fhnw-ise-qcrypt/qsit_psd_payload_module_kicad/assembly/QSIT_PayloadADCboard.png

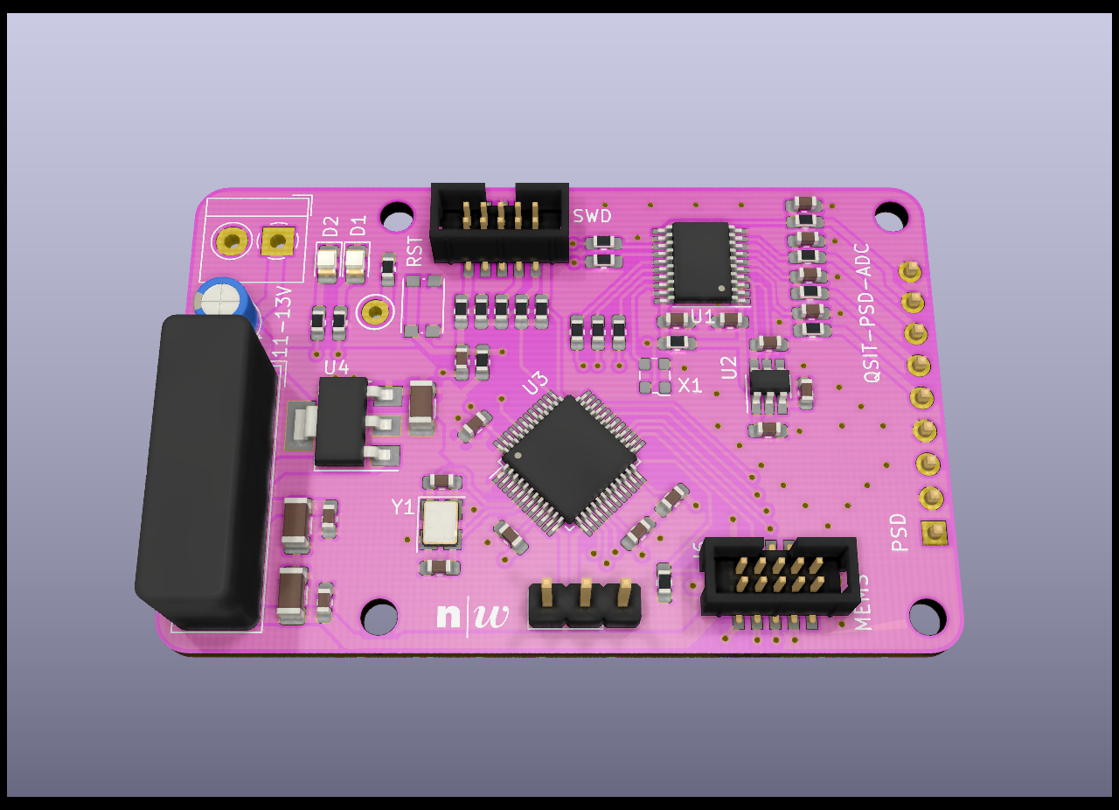
assembly/QSIT_PayloadADCboard.png
