fhnw-ise-qcrypt/qsit_psd_payload_module_kicad/assembly/QSIT_PayloadPSDmodule.png

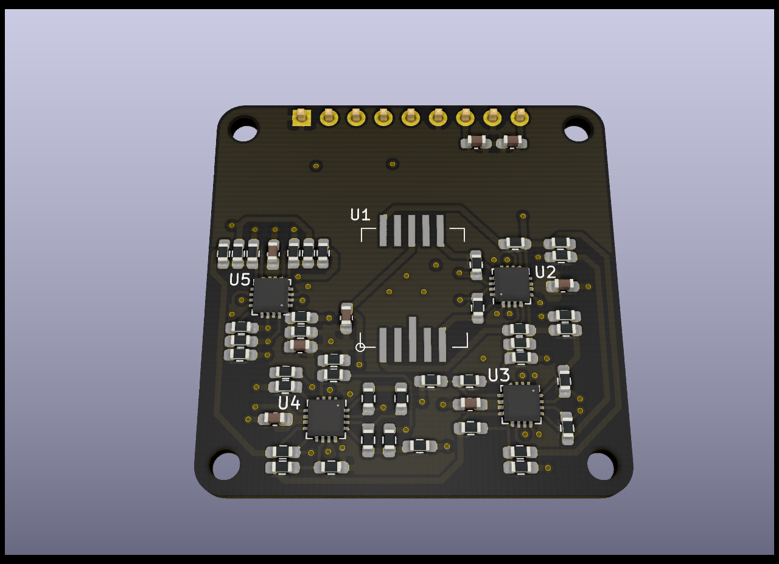
assembly/QSIT_PayloadPSDmodule.png
