fhnw-ise-qcrypt/qsit_psd_payload_module_kicad/README.md

# qsit_psd_payload_module_kicad
kicad drawings to interface a position sensitive detector (diode) for the QSIT payload

### BOM

https://octopart.com/bom-tool/2UpAKjyw
