fhnw-ise-qcrypt/qsit_psd_payload_module_kicad/assembly/2_boards_assembly.pdf

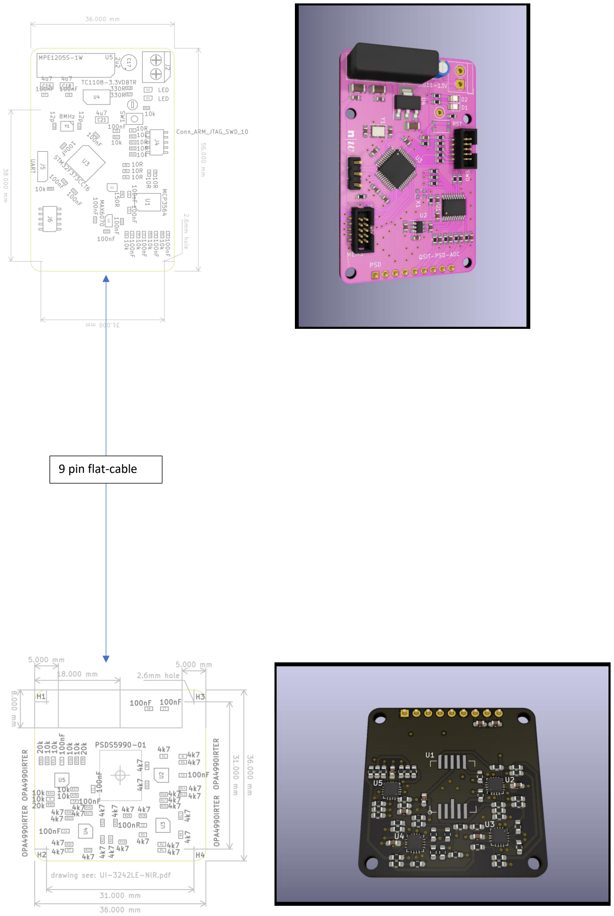
[picture p3: page 1]

9 pin flat-cable
