fhnw-ise-qcrypt/qsit_psd_payload_module_kicad/assembly/PSD_Frontend_Assembly.pdf

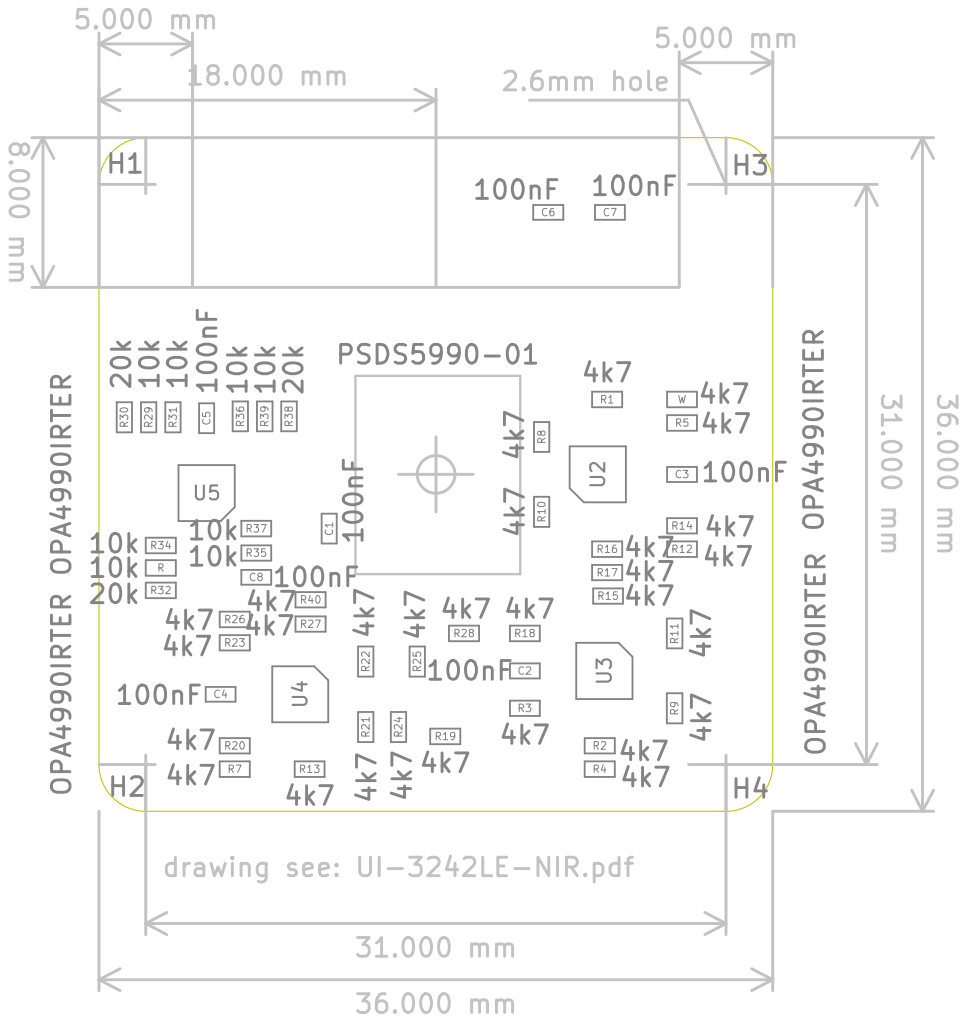
[picture p4: page 1]
