fhnw-ise-qcrypt/qsit_psd_payload_module_kicad/pdf/PSD_Frontend_Schematics.pdf

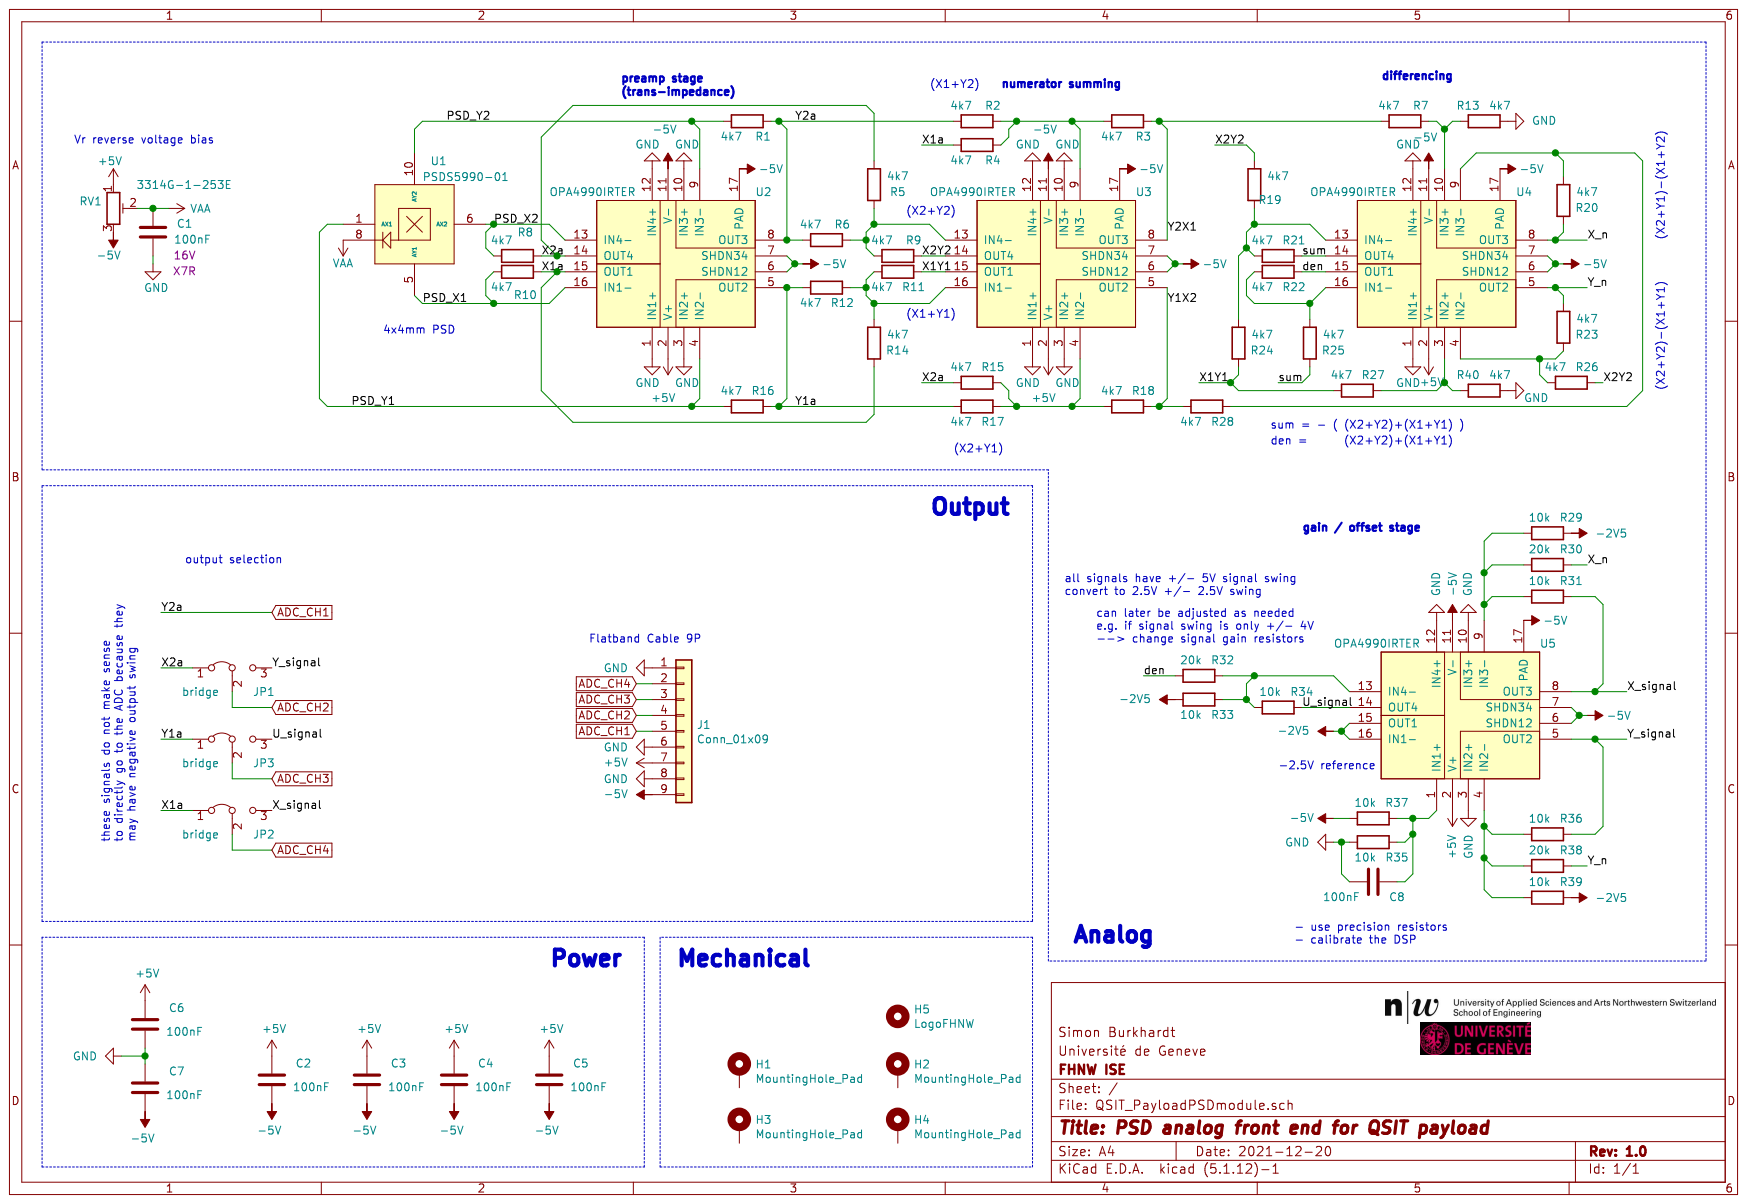
[picture p5: page 1]
