fhnw-ise-qcrypt/qsit_psd_payload_module_kicad/assembly/STM32_ADC_Board_Assembly.pdf

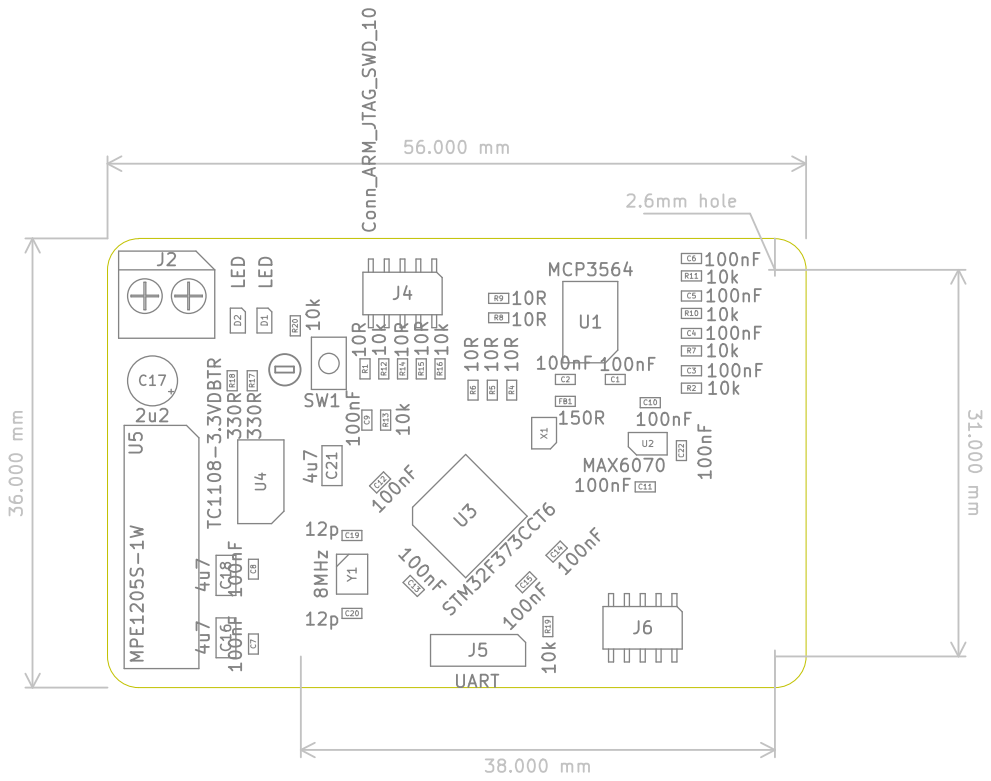
[picture p6: page 1]
