fhnw-ise-qcrypt/qsit_psd_payload_module_kicad/pdf/STM32_ADC_Board_Schematics.pdf

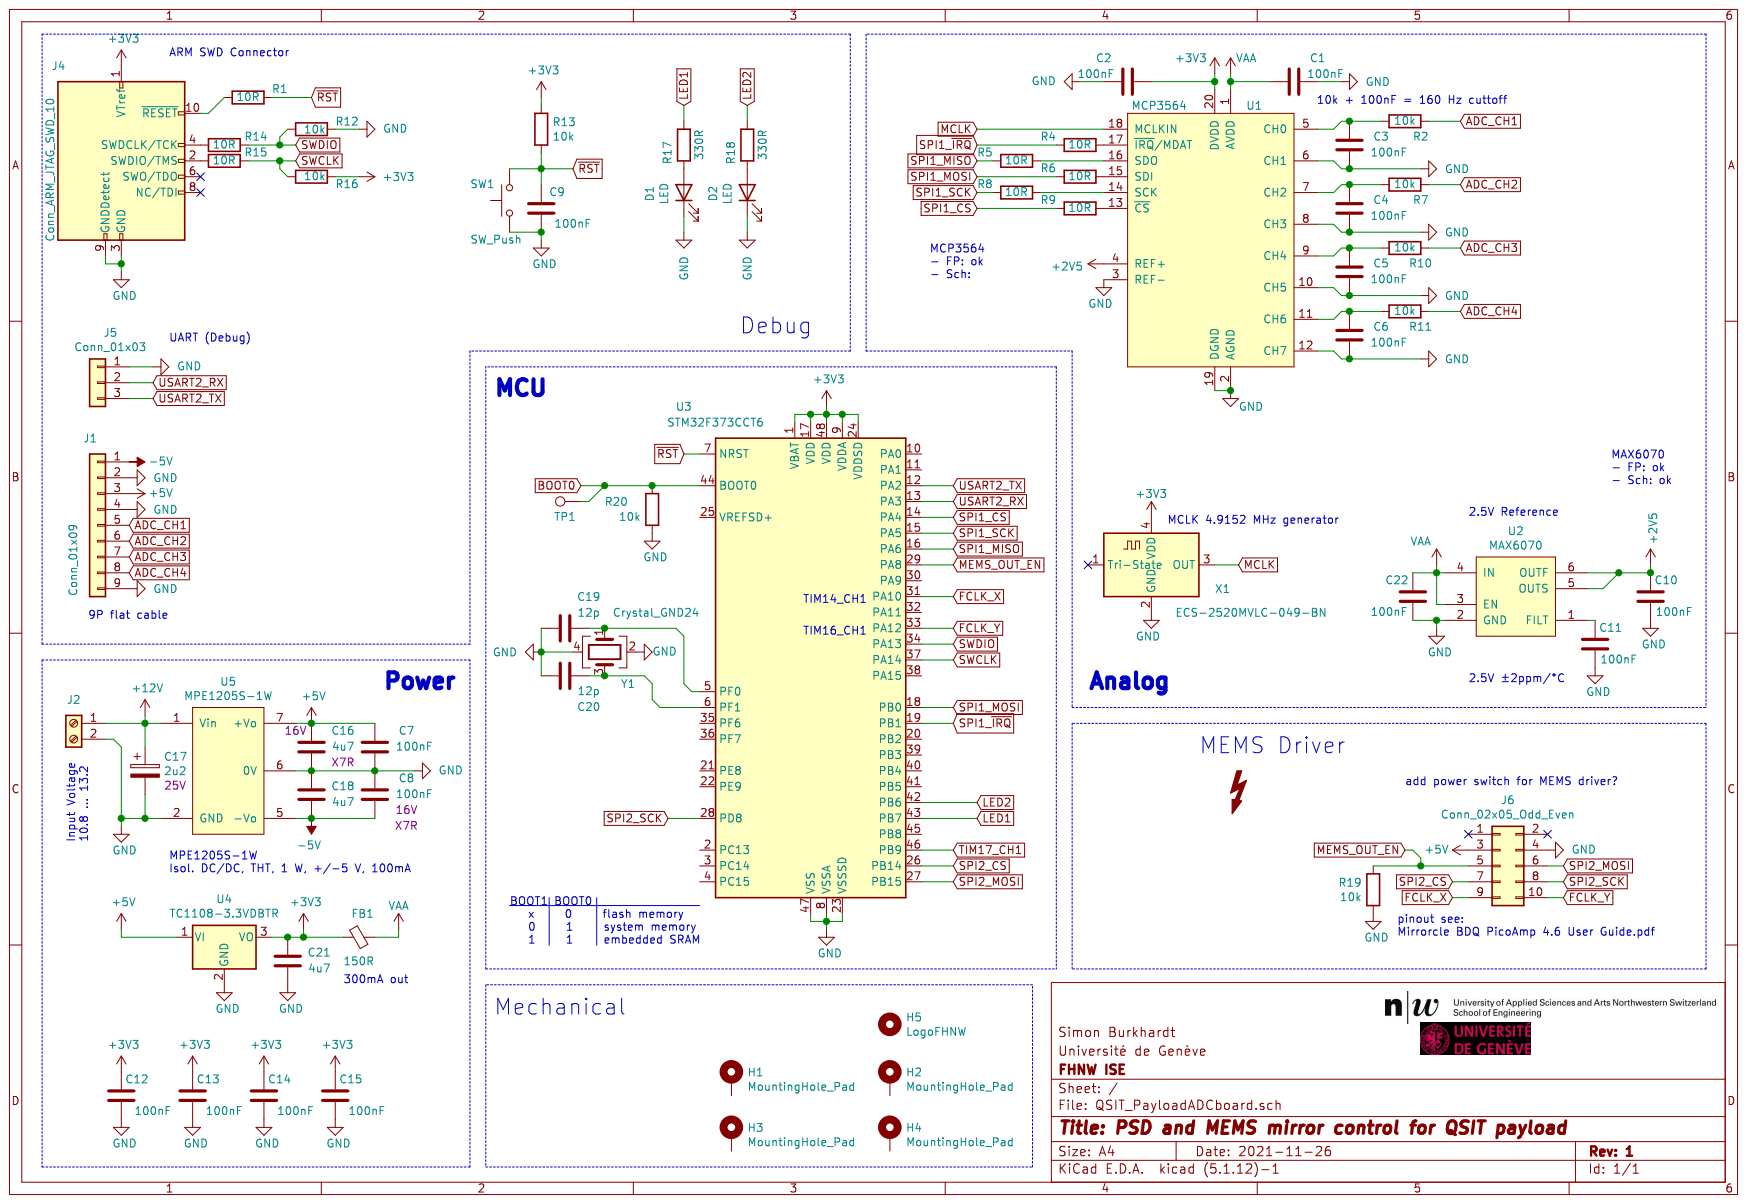
[picture p7: page 1]
