fhnw-ise-qcrypt/qsit_psd_payload_module_kicad/simulation/single_ended_ADC_driver/single_ended_ADC_driver.asc

R29: res; 10k
R30: res; 20k
R31: res; 10k
U5: LT1677
V1: voltage; 2.5
V2: voltage; 5
V3: voltage; 5
V4: voltage; SINE(0 5 50)
Named nets: 0, +5V, -5V, -2.5V, X_signal, X_n
.lib opamp.sub
.tran 20m
+/- 5V swing
0 ... 5V swing
