fhnw-ise-qcrypt/qsit_psd_payload_module_kicad/kicad/adc_board/QSIT_PayloadADCboard.kicad_pcb

## KiCad design kicad/adc_board/QSIT_PayloadADCboard.kicad_pcb (2021-12-20)

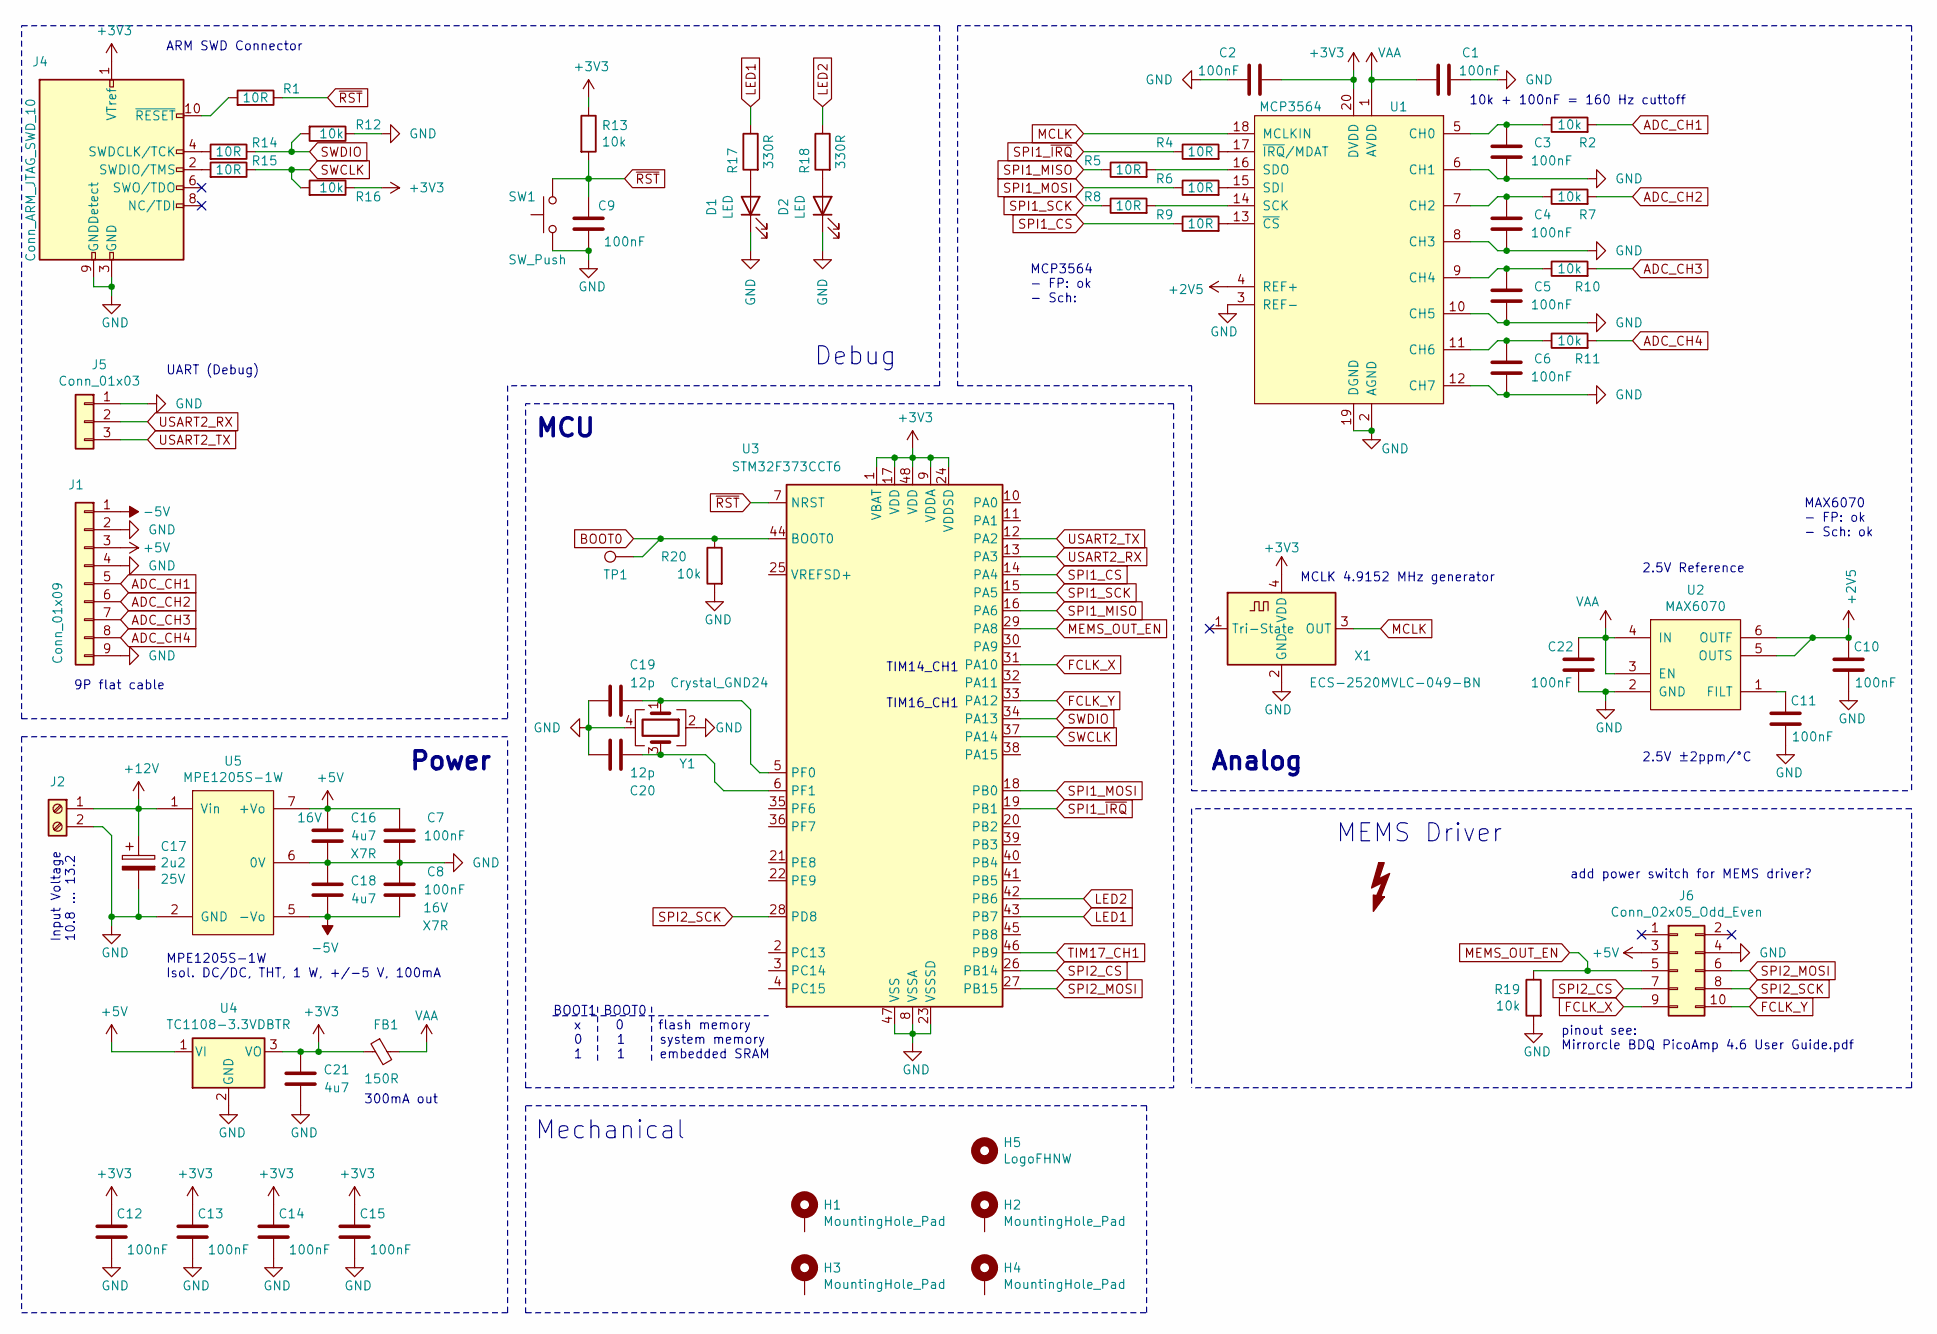
[picture p23: schematic QSIT_PayloadADCboard.sch, PSD and MEMS mirror control for QSIT payload]

Parts:
C1, C2, C3, C4, C5, C6, C7, C8, C9, C10, C11, C12, C13, C14, C15: 100nF; C_0603_1608Metric_Pad1.05x0.95mm_HandSolder; Voltage 16V
C16, C18, C21: 4u7; C_1206_3216Metric; Voltage 16V
C17: 2u2; CP_Radial_D4.0mm_P2.00mm; Voltage 25V
C19, C20: 12p; C_0603_1608Metric_Pad1.05x0.95mm_HandSolder; Voltage 16V
C22: 100nF; C_0603_1608Metric; Voltage 16V
D1, D2: LED; LED_0805_2012Metric_Pad1.15x1.40mm_HandSolder
FB1: 150R; R_0603_1608Metric_Pad1.05x0.95mm_HandSolder
H1, H2, H3, H4: MountingHole_Pad; MountingHole_2.5mm
H5: LogoFHNW; Logo_FHNW_03x05mm
J1: Conn_01x09; PinHeader_1x09_P2.54mm_Vertical
J2: Power_Conn; TerminalBlock_4Ucon_1x02_P3.50mm_Horizontal
J4: Conn_ARM_JTAG_SWD_10; PinHeader_2x05_P1.27mm_Vertical_SMD
J5: Conn_01x03; PinHeader_1x03_P2.54mm_Vertical
J6: Conn_02x05_Odd_Even; PinHeader_2x05_P1.27mm_Vertical_SMD
R1, R4, R5, R6, R8, R9, R14, R15: 10R; R_0603_1608Metric_Pad1.05x0.95mm_HandSolder
R2, R7, R10, R11, R12, R13, R16, R19, R20: 10k; R_0603_1608Metric_Pad1.05x0.95mm_HandSolder
R17, R18: 330R; R_0603_1608Metric_Pad1.05x0.95mm_HandSolder
SW1: SW_Push; SW_Push_1P1T_NO_CK_KMR2
TP1: TestPoint; TestPoint_Keystone_5000-5004_Miniature
U1: MCP3564; TSSOP-20_4.4x6.5mm_P0.65mm
U2: MAX6070; SOT-23-6_Handsoldering
U3: STM32F373CCT6; LQFP-48_7x7mm_P0.5mm
U4: TC1108-3.3VDBTR; SOT-223-3_TabPin2
U5: MPE1205S-1W; Converter_DCDC_multicorp_THT
X1: ECS-2520MVLC-049-BN; Oscillator_SMD_ECS_2520MV-xxx-xx-4Pin_2.5x2.0mm
Y1: Crystal_GND24; Crystal_SMD_TXC_7M-4Pin_3.2x2.5mm

Connections:
+2V5: C10.2, U1.4 (REF+), U2.5 (OUTS), U2.6 (OUTF)
+3V3: C2.1, C12.2, C13.2, C14.2, C15.2, C21.2, FB1.1, J4.1 (VTref), R13.1, R16.1, U1.20 (DVDD), U3.1 (VBAT), U3.9 (VDDA), U3.17 (VDD), U3.24 (VDDSD), U3.48 (VDD), U4.3 (VO), X1.4 (VDD)
+5V: C7.2, C16.2, J1.3, J6.3, U4.1 (VI), U5.7 (+Vo)
+12V: C17.1, J2.1, U5.1 (Vin)
-5V: C8.1, C18.1, J1.1, U5.5 (-Vo)
ADC_CH1: J1.5, R2.2
ADC_CH2: J1.6, R7.2
ADC_CH3: J1.7, R10.2
ADC_CH4: J1.8, R11.2
BOOT0: R20.1, TP1.1, U3.44 (BOOT0)
FCLK_X: J6.9, U3.31 (PA10)
FCLK_Y: J6.10, U3.33 (PA12)
GND: C1.2, C2.2, C3.1, C4.1, C5.1, C6.1, C7.1, C8.2, C9.1, C10.1, C11.1, C12.1, C13.1, C14.1, C15.1, C16.1, C17.2, C18.2, C19.2, C20.2, C21.1, C22.1, D1.1 (K), D2.1 (K), J1.2, J1.4, J1.9, J2.2, J4.3 (GND), J4.5 (GND), J4.9 (GNDDetect), J5.1, J6.4, R12.1, R19.2, R20.2, SW1.1, U1.2 (AGND), U1.3 (REF-), U1.6 (CH1), U1.8 (CH3), U1.10 (CH5), U1.12 (CH7), U1.19 (DGND), U2.2 (GND), U3.8 (VSSA), U3.23 (VSSSD), U3.47 (VSS), U4.2 (GND), U5.2 (GND), U5.6 (0V), X1.2 (GND), Y1.2, Y1.4
LED1: R17.1, U3.43 (PB7)
LED2: R18.1, U3.42 (PB6)
MCLK: U1.18 (MCLKIN), X1.3 (OUT)
MEMS_OUT_EN: J6.5, R19.1, U3.29 (PA8)
unnamed: C3.2, R2.1, U1.5 (CH0)
unnamed: C4.2, R7.1, U1.7 (CH2)
unnamed: C5.2, R10.1, U1.9 (CH4)
unnamed: C6.2, R11.1, U1.11 (CH6)
unnamed: C11.2, U2.1 (FILT)
unnamed: C19.1, U3.5 (PF0), Y1.1
unnamed: C20.1, U3.6 (PF1), Y1.3
unnamed: D1.2 (A), R17.2
unnamed: D2.2 (A), R18.2
unnamed: J4.2 (SWDIO/TMS), R15.2
unnamed: J4.4 (SWDCLK/TCK), R14.2
unnamed: J4.10 (~RESET~), R1.2
unnamed: R4.2, U1.17 (~IRQ~/MDAT)
unnamed: R5.2, U1.16 (SDO)
unnamed: R6.2, U1.15 (SDI)
unnamed: R8.2, U1.14 (SCK)
unnamed: R9.2, U1.13 (~CS~)
SPI1_CS: R9.1, U3.14 (PA4)
SPI1_MISO: R5.1, U3.16 (PA6)
SPI1_MOSI: R6.1, U3.18 (PB0)
SPI1_SCK: R8.1, U3.15 (PA5)
SPI1_~IRQ~: R4.1, U3.19 (PB1)
SPI2_CS: J6.7, U3.26 (PB14)
SPI2_MOSI: J6.6, U3.27 (PB15)
SPI2_SCK: J6.8, U3.28 (PD8)
SWCLK: R15.1, R16.2, U3.37 (PA14)
SWDIO: R12.2, R14.1, U3.34 (PA13)
TIM17_CH1: U3.46 (PB9)
USART2_RX: J5.2, U3.13 (PA3)
USART2_TX: J5.3, U3.12 (PA2)
VAA: C1.1, C22.2, FB1.2, U1.1 (AVDD), U2.3 (EN), U2.4 (IN)
~RST: C9.2, R1.1, R13.2, SW1.2, U3.7 (NRST)

Notes on the sheet:
10k + 100nF = 160 Hz cuttoff
pinout see: Mirrorcle BDQ PicoAmp 4.6 User Guide.pdf
add power switch for MEMS driver?
MPE1205S-1W Isol. DC/DC, THT, 1 W, +/-5 V, 100mA
300mA out
2.5V ±2ppm/°C
Input Voltage 10.8 ... 13.2
ARM SWD Connector
UART (Debug)
2.5V Reference
9P flat cable
MCLK 4.9152 MHz generator
Power
MCU
Debug
Analog
MEMS Driver
Mechanical
BOOT1 BOOT0 x 0 flash memory 0 1 system memory 1 1 embedded SRAM
MAX6070 - FP: ok - Sch: ok
MCP3564 - FP: ok - Sch:
TIM14_CH1
TIM16_CH1

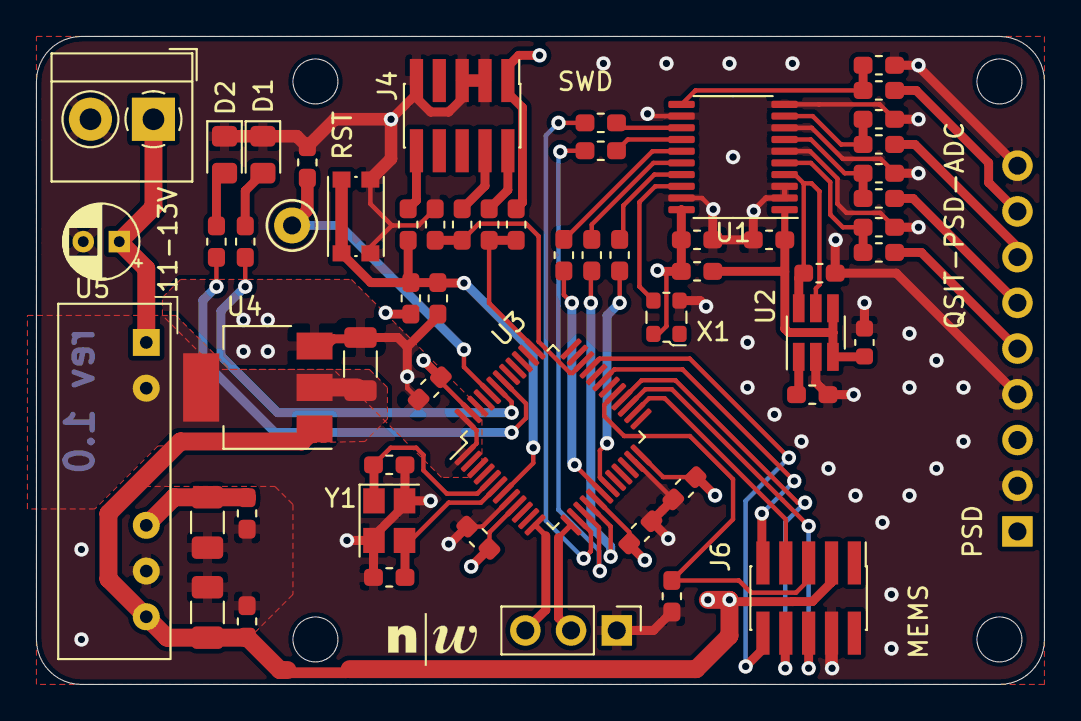
[picture p24: board QSIT_PayloadADCboard.kicad_pcb from above]

Board: 4 copper layers, 56.0 x 36.0 mm, 63 parts (1 on the bottom side), 48 nets.
