fhnw-ise-qcrypt/qsit_psd_payload_module_kicad/kicad/analog_frontend/QSIT_PayloadPSDmodule.kicad_pcb

## KiCad design kicad/analog_frontend/QSIT_PayloadPSDmodule.kicad_pcb (2021-12-20)

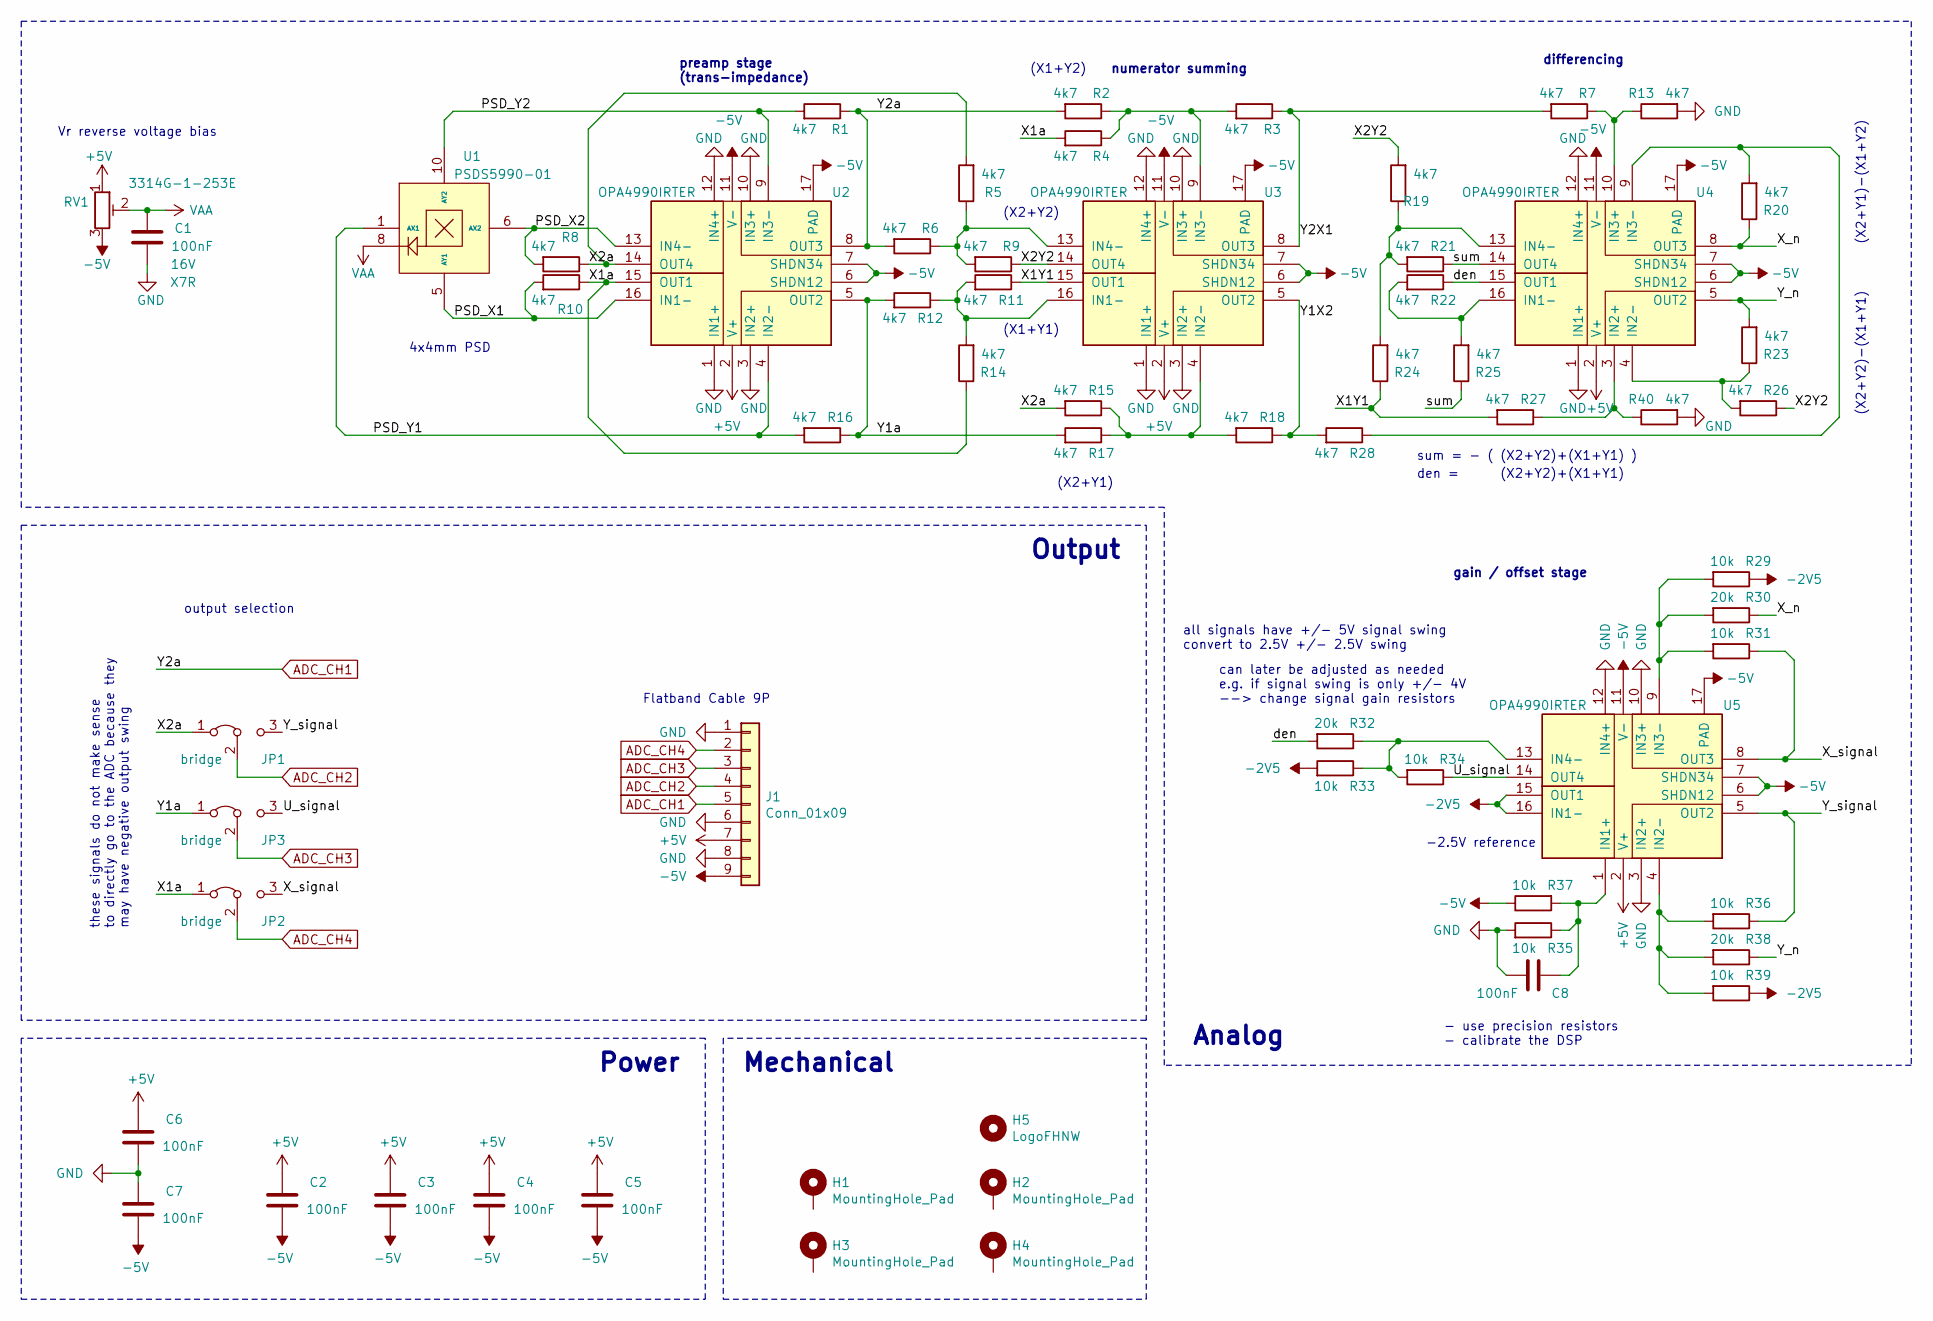
[picture p25: schematic QSIT_PayloadPSDmodule.sch, PSD analog front end for QSIT payload]

Parts:
C1: 100nF; C_0603_1608Metric_Pad1.08x0.95mm_HandSolder; Voltage 16V
C2, C3, C4, C5, C6, C7, C8: 100nF; C_0603_1608Metric_Pad1.08x0.95mm_HandSolder
H1, H2, H3, H4: MountingHole_Pad; MountingHole_2.5mm
H5: LogoFHNW; Logo_FHNW_03x05mm
J1: Conn_01x09; PinHeader_1x09_P2.54mm_Vertical
JP1, JP2, JP3: bridge; SolderJumper-3_P1.3mm_Open_RoundedPad1.0x1.5mm
R1, R2, R3, R4, R5, R6, R7, R8, R9, R10, R11, R12, R13, R14, R15, R16, R17, R18, R19, R20, R21, R22, R23, R24, R25, R26, R27, R28, R40: 4k7; R_0603_1608Metric_Pad0.98x0.95mm_HandSolder
R29, R31, R33, R34, R35, R36, R37, R39: 10k; R_0603_1608Metric_Pad0.98x0.95mm_HandSolder
R30, R32, R38: 20k; R_0603_1608Metric_Pad0.98x0.95mm_HandSolder
RV1: 3314G-1-253E; Potentiometer_Bourns_3314R-GM5_Vertical
U1: PSDS5990-01; HAMAMATSU_PSD_S599001_4mm
U2, U3, U4, U5: OPA4990IRTER; WQFN-16-1EP_3x3mm_P0.5mm_EP1.6x1.6mm

Connections:
+5V: C2.2, C3.2, C4.2, C5.2, C6.2, J1.7, RV1.1, U2.2 (V+), U3.2 (V+), U4.2 (V+), U5.2 (V+)
-2V5: R29.1, R33.2, R39.1, U5.15 (OUT1), U5.16 (IN1-); also elsewhere on the board
-5V: C2.1, C3.1, C4.1, C5.1, C7.1, J1.9, R37.1, RV1.3, U2.6 (SHDN12), U2.7 (SHDN34), U2.11 (V-), U2.17 (PAD), U3.6 (SHDN12), U3.7 (SHDN34), U3.11 (V-), U3.17 (PAD), U4.6 (SHDN12), U4.7 (SHDN34), U4.11 (V-), U4.17 (PAD), U5.6 (SHDN12), U5.7 (SHDN34), U5.11 (V-), U5.17 (PAD)
/PSD_X1: R10.2, U1.5 (AY1), U2.16 (IN1-)
/PSD_X2: R8.2, U1.6 (AX2), U2.13 (IN4-)
/PSD_Y1: R16.2, U1.1 (AX1), U2.4 (‌IN2-)
/PSD_Y2: R1.2, U1.10 (AY2), U2.9 (IN3-)
/U_signal: JP3.3 (B), R34.1, U5.14 (OUT4)
/X1Y1: R11.1, R24.1, R27.2, U3.15 (OUT1)
/X1a: JP2.1 (A), R4.2, R10.1, R14.1, U2.15 (OUT1)
/X2Y2: R9.1, R19.2, R26.1, U3.14 (OUT4)
/X2a: JP1.1 (A), R5.2, R8.1, R15.2, U2.14 (OUT4)
/X_n: R20.1, R30.1, U4.8 (OUT3)
/X_signal: JP2.3 (B), R31.1, U5.8 (OUT3)
/Y1X2: R18.1, R28.2, U3.5 (OUT2)
/Y1a: JP3.1 (A), R12.2, R16.1, R17.2, U2.5 (OUT2)
/Y2X1: R3.1, R7.2, U3.8 (OUT3)
/Y_n: R23.2, R38.1, U4.5 (OUT2)
/Y_signal: JP1.3 (B), R36.1, U5.5 (OUT2)
/den: R22.1, R32.2, U4.15 (OUT1)
/sum: R21.1, R25.1, U4.14 (OUT4)
ADC_CH1: J1.5, R1.1, R2.2, R6.2, U2.8 (OUT3); also elsewhere on the board
ADC_CH2: J1.4, JP1.2 (C)
ADC_CH3: J1.3, JP3.2 (C)
ADC_CH4: J1.2, JP2.2 (C)
GND: C1.1, C6.1, C7.2, C8.1, J1.1, J1.6, J1.8, R13.2, R35.2, R40.2, U2.1 (IN1+), U2.3 (IN2+), U2.10 (IN3+), U2.12 (IN4+), U3.1 (IN1+), U3.3 (IN2+), U3.10 (IN3+), U3.12 (IN4+), U4.1 (IN1+), U4.12 (IN4+), U5.3 (IN2+), U5.10 (IN3+), U5.12 (IN4+)
unnamed: C8.2, R35.1, R37.2, U5.1 (IN1+)
unnamed: R2.1, R3.2, R4.1, U3.9 (IN3-)
unnamed 32: R5.1, R6.1, R9.2, U3.13 (IN4-); also elsewhere on the board
unnamed: R11.2, R12.1, R14.2, U3.16 (IN1-)
unnamed: R7.1, R13.1, U4.10 (IN3+)
unnamed: R15.1, R17.1, R18.2, U3.4 (‌IN2-)
unnamed: R19.1, R21.2, R24.2, U4.13 (IN4-)
unnamed: R20.2, R28.1, U4.9 (IN3-)
unnamed: R22.2, R25.2, U4.16 (IN1-)
unnamed: R23.1, R26.2, U4.4 (‌IN2-)
unnamed: R27.1, R40.1, U4.3 (IN2+)
unnamed: R29.2, R30.2, R31.2, U5.9 (IN3-)
unnamed 42: R32.1, R33.1, R34.2, U5.13 (IN4-); also elsewhere on the board
unnamed: R36.2, R38.2, R39.2, U5.4 (‌IN2-)
VAA: C1.2, RV1.2, U1.8

Notes on the sheet:
Vr reverse voltage bias
4x4mm PSD
preamp stage (trans-impedance)
numerator summing
differencing
(X2+Y1)
(X1+Y2)
(X1+Y1)
(X2+Y2)
(X2+Y1)-(X1+Y2)
(X2+Y2)-(X1+Y1)
den = (X2+Y2)+(X1+Y1)
sum = - ( (X2+Y2)+(X1+Y1) )
gain / offset stage
all signals have +/- 5V signal swing convert to 2.5V +/- 2.5V swing
can later be adjusted as needed e.g. if signal swing is only +/- 4V --> change signal gain resistors
Flatband Cable 9P
Mechanical
-2.5V reference
Power
Output
Analog
output selection
these signals do not make sense to directly go to the ADC because they may have negative output swing
- use precision resistors - calibrate the DSP

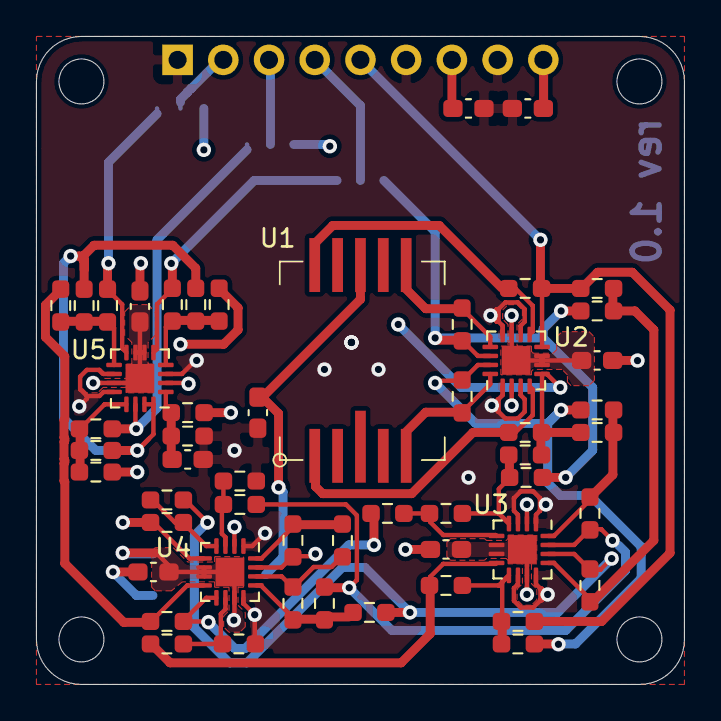
[picture p26: board QSIT_PayloadPSDmodule.kicad_pcb from above]

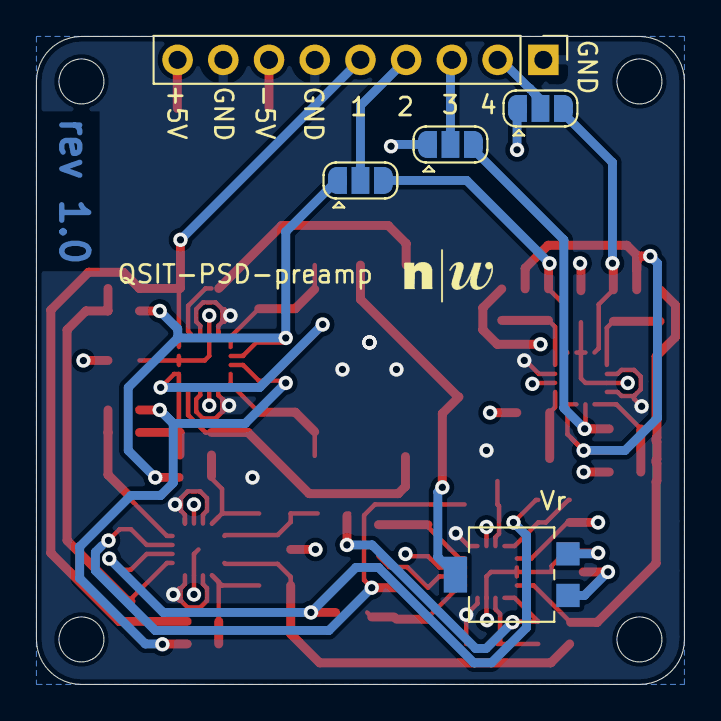
[picture p27: board QSIT_PayloadPSDmodule.kicad_pcb from below]

Board: 4 copper layers, 36.0 x 36.0 mm, 63 parts (6 on the bottom side), 41 nets.

Other parts of the board:
R: 10k; R_0603_1608Metric_Pad0.98x0.95mm_HandSolder
W: 4k7; R_0603_1608Metric_Pad0.98x0.95mm_HandSolder

Their connections:
-2V5: R.2; also elsewhere on the board
ADC_CH1: W.2; also elsewhere on the board
unnamed 32: W.1; also elsewhere on the board
unnamed 42: R.1; also elsewhere on the board
