fhnw-ise-qcrypt/qsit_psd_payload_module_kicad/(commit log)

2021-11-24 initial analog opamp version
    [QSIT_PayloadPSDmodule.kicad_pcb, QSIT_PayloadPSDmodule.sch]
2021-11-29 new ADC board
    [QSIT_PayloadADCboard.kicad_pcb, QSIT_PayloadADCboard.sch, QSIT_PayloadPSDmodule.kicad_pcb, QSIT_PayloadPSDmodule.sch]
2021-12-03 changed to single 9pin connector
    [QSIT_PayloadADCboard.kicad_pcb, QSIT_PayloadADCboard.sch]
2021-12-03 added stm32f373cct6
    [QSIT_PayloadPSDmodule.kicad_pcb, QSIT_PayloadPSDmodule.sch]
2021-12-06 STM32 board ready for review
    [QSIT_PayloadADCboard.kicad_pcb, QSIT_PayloadADCboard.sch]
2021-12-10 further pcb improvements
    [QSIT_PayloadADCboard.kicad_pcb, QSIT_PayloadADCboard.sch]
2021-12-10 rev.1 of ADC board
    [QSIT_PayloadADCboard.kicad_pcb, QSIT_PayloadADCboard.sch]
2021-12-20 ignore gerber
2021-12-20 rev 1 finished - final check on PSD frontend - plotted gerbber for jlc - added simulation for PSD frontend
    [QSIT_PayloadADCboard.kicad_pcb, QSIT_PayloadPSDmodule.kicad_pcb, QSIT_PayloadPSDmodule.sch, QSIT_PayloadPSDmodule_BOM.xlsx]
2022-02-07 added assembly documentation
    [QSIT_PayloadADCboard_BOM.xlsx, QSIT_PayloadPSDmodule_BOM.xlsx]
